30sectomars/psas_testbot/doku/Ausarbeitung.pdf

PROJEKTSEMINAR AUTOMATISIERUNGSTECHNIK, VOL. 12, WS 18/19

# Autonome Kurvenfahrt eines schlangenähnlichen Roboters in dem Strahlrohr eines Ringbeschleunigers

Jens Balze, Nursura Demircan, Elias Jargon, Seyed Davood Mousavi

Zusammenfassung— Bereits heute werden mehrgliedrige, schlangenähnliche Roboter auf Bohrinseln und bei Ölpipelines für Inspektions-, Instandhaltungs- und Reparaturarbeiten eingesetzt. Diese Arbeit setzt sich mit der Regelung der Bewegung eines solchen Roboters, der zukünftig zur Inspektion innerhalb eines Teilchenbeschleunigers eingesetzt werden soll, auseinander. Dabei soll die Fahrt des Roboters so geregelt werden, dass der Roboter sich durch ein Rohr mit ellipsenförmiger Querschnittsfläche bewegen kann. Dieses Rohr besteht aus geraden und gebogenen Abschnitten. Zu diesem Zweck wird in dieser Arbeit ein Modell, das die Bewegung des Roboters im Rohr beschreibt, entworfen. Auf Grundlage dieses Modells werden verschiedene Regelkonzepte ausgelegt und verglichen. Mit diesen entworfenen Reglern ist es dem Roboter möglich, durch ein Modell eines Rohres des Ringbeschleunigers, der zurzeit bei der Gesellschaft für Schwerionenforschung in Darmstadt entsteht, zu fahren. Zudem kann der Roboter mit diesen Reglern ein Rohr einer realen Teststrecke durchfahren, bei dem die Bedingungen durch engere Kurven verschärft wurden. Des Weiteren wird sich mit der Wahl und der Messung einer geeigneten Regelgröße auseinandergesetzt.

Abstract— Already today, multi-limbed, snake-like robots are used on drilling rigs and oil pipelines for inspection, maintenance and repair. This paper deals with the regulation of the movement of such a robot, which should be used for the inspection within a particle accelerator in the future. The aim is to control the motion of the robot so that the robot can move through a pipe. This pipe consists straight and curved sections. For this purpose, a model describing the motion of the robot is derivated in this work. Based on this model, different control concepts are designed. In addition, the robot can use these controllers to drive through a pipe that has tightened the conditions with tighter bends. Furthermore, the choice of the present control variable is discussed.

I. EINFÜHRUNG

Ein wichtiges Einsatzgebiet von mobilen Robotern sind Gebiete, die für den Menschen nicht bzw. schwer zugänglich sind. So werden mobile Roboter beispielsweise in lebensfeindlichen Gebieten zur Erkundung der Ozeane [1] oder des Mars eingesetzt, in gefährlichen Krisengebieten bei Such- und Rettungsaktionen [2] und in einer Vielzahl weiterer Einsatzgebiete. Des Weiteren werden die mobilen Roboter in für den Menschen räumlich unzugänglichen Umgebungen eingesetzt. So wie ein

Diese Arbeit wurde von Nicolai Schweizer, M.Sc. unterstützt.

Roboter, der derzeit am Fachgebiet Regelungsmethoden und Robotik der TU Darmstadt entwickelt wird.
Dieser Roboter soll sich durch das Strahlrohr eines Ringbeschleunigers bewegen, um dort bei möglichen Wartungsarbeiten liegengebliebene Werkzeuge oder andere Fremdkörper zu entdecken und zu lokalisieren. Denn diese Fremdkörper können die Funktion und die Strahlqualität des Ringbeschleunigers stark beeinträchtigen. Da das Strahlrohr, dessen Querschnitt aus einer Ellipse mit den Halbachsen von 30 mm und 60 mm besteht (vgl. II-B), für den Menschen nicht zugänglich ist, müsste er bei der Suche nach einem Fremdkörper an vielen Stellen geöffnet werden, bis der Fremdkörper entdeckt wird. Durch einen Roboter, der sich durch das Strahlrohr bewegt, muss der Ringbeschleuniger nur an einer Stelle geöffnet werden, um den Roboter einzusetzen. Nach der Entdeckung und Lokalisierung des Fremdkörpers muss das Strahlrohr dann nur noch an einer entsprechenden zweiten Stelle geöffnet werden, um den Fremdkörper zu entfernen. Zudem kann der Roboter zur visuellen Inspektion verwendet werden. Der Roboter soll für den bei der Gesellschaft für Schwerionenforschung (GSI) entstehenden Ringbeschleuniger entwickelt werden, aber auch in anderen Ringbeschleunigern einsetzbar sein [3].
Da sich der Roboter nur sehr langsam bewegt und der Ringbeschleuniger der GSI eine Länge von ca. 1100 m hat, ist es wünschenswert, dass der Roboter sich autonom Fortbewegen kann. Zu diesem Zweck soll in dieser Arbeit eine Regelung entworfen werden, die dem Roboter sowohl durch gerade auch gebogene Rohrabschnitte des Teilchenbeschleunigers eine autonome Fahrt ermöglicht. Diese Regelung soll zum einen verhindern, dass der Roboter kippt. Zum anderen soll er einen möglichen Grip-Verlust des Roboters im Rohr vermeiden, denn damit ist ein möglicher Abrieb der Räder verbunden, der die Funktion des Beschleunigers beeinträchtigen kann. Zu diesem Zweck muss der Roboter von der Regelung so durch das Rohr gelenkt werden, dass ein Auffahren an den Rohrwänden verhindert wird, da dies zum Kippen bzw. zum Grip-Verlust führen kann. Die Regelung soll also dafür sorgen, dass sich der Roboter möglichst immer am untersten Punkt des Querschnittes im Rohr befindet.
Der schlangenähnliche Roboter (Abb. 7) besteht aus vier Modulen, die jeweils ein Paar Räder besitzen. Die Module sind über Gelenke miteinander verbunden. Derzeit ist der Roboter in der Lage manuell gesteuert zu werden. Dabei wird eine Geschwindigkeit und ein Lenkwinkel vorgegeben. Aus diesen Werten berechnet ein Algorithmus die nötigen Sollwinkel für die Gelenke und die Geschwindigkeiten für

die einzelnen Räder. Eine ausführlichere Beschreibung des Aufbaus des Roboters zum Zeitpunkt des Beginns der Arbeit und eine Beschreibung der kinematischen Berechnungen zur manuellen Steuerung finden sich in [4].
Zur Umsetzung der Regelung wird der Roboter durch ein passives Gelenk zwischen dem ersten und dem zweiten Modul erweitert, welches eine unabhängige Rollbewegung des ersten Moduls gegen-über dem restlichen Roboter zulässt. Zudem wird eine inertiale Messeinheit (IMU) an der Spitze des ersten Moduls angebracht. Diese hardwaretechnischen Veränderungen werden genauer in Kapitel IV beschrieben.
Nach der Erläuterung einiger Grundlagen zur Bewegung von Rädern in Rohren und einer kurzen Vorstellung der Simulation und der Teststrecke im Kapitel II, wird näher auf die Modellbildung des Systems Roboter im Rohr eingegangen (Kapitel III). Dieses Modell soll als Grundlage zur Wahl verschiedener Regelkonzepte und deren Auslegung dienen. Weiterhin wird in Kapitel IV die Problematik bei der Messung der Regelgröße bzw. der Zustandsgrößen beschrieben. Kapitel V stellt dann die verschiedenen Regelkonzepte und Auslegungen vor, bevor diese in Kapitel VI verglichen und bewertet werden.

II. GRUNDLAGEN

In diesem Kapitel werden einige kinematische Grundlagen zur Bewegung von Rädern und Robotern im Rohr erläutert, die in der Modellbildung vorausgesetzt werden. Zudem wird auf den Komplementärfilter eingegangen, der die vom IMU-Sensor aufgenommenen Werte aufbereitet. Letztlich werden noch die Teststrecke und die Simulation vorgestellt.

A. Bewegung von Rädern und Achsen im Rohr
Um die Bewegung eines Rades in einem Rohr mit kreisförmigem Querschnitt zu beschreiben, müssen zunächst einige Winkel und Koordinaten eingeführt werden. Das Inertialsystem liegt am Beginn des Rohres im Mittelpunkt M der kreisförmigen Grundfläche. Die z-Achse zeigt entlang des Rohres Abb. 1.

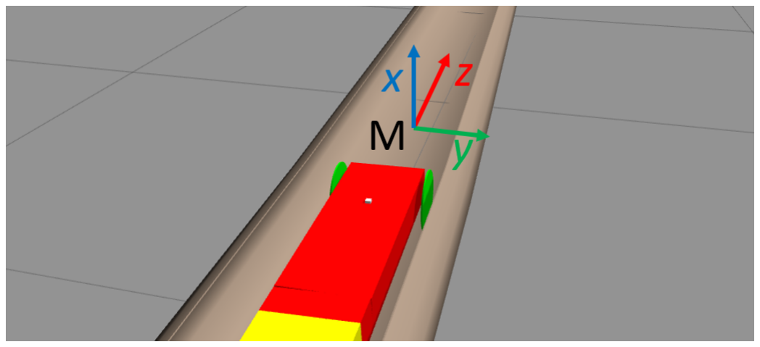
[picture p21: figure]

Abb. 1. Inertialsystem

Zudem wird ein Koordinatensystem eingeführt, dass seinen Ursprung im Aufstandspunkt des Rades auf der Innenfläche des Zylinders, welcher das Rohr beschreibt, hat. Dieser Punkt wird mit Q bezeichnet. Das Koordinatensystem wird nun durch (τ ,b,n) aufgespannt. Dabei zeigt die τ -Achse in die Bewegungsrichtung des Roboters. Sie stellt also eine Tangente zur Rohroberfläche im Punkt Q dar. Die b-Achse ist ebenfalls eine Tangente im Punkt Q auf die Oberfläche des Rohres. Die b-Achse steht senkrecht auf der Bewegungsrichtung. Damit ergibt sich für die n-Achse, dass sie senkrecht auf der Rohroberfläche steht und somit in Richtung der Rohrachse zeigt. r bezeichnet den Radius des Rades. Der Winkel zwischen dem Rad und der n-Achse wird als β bezeichnet. Des Weiteren wird noch der Winkel ψ benötigt. ψ wird zur Beschreibung des Gierwinkels des Roboters verwendet. Er wird von einer parallelen zur z-Achse und der Bewegungsrichtung aufgespannt. Da dieser Winkel später für Rad und Roboter gleich ist wird auch für das Rad ψ verwendet. In Abb. 2 wird er durch die gestrichelten Linien m und l aufgespannt. Wobei l eine Parallele zur z-Achse ist und m die Verlängerung von der τ -Achse ist. Neben dem Gierwinkel ψ, werden auch für

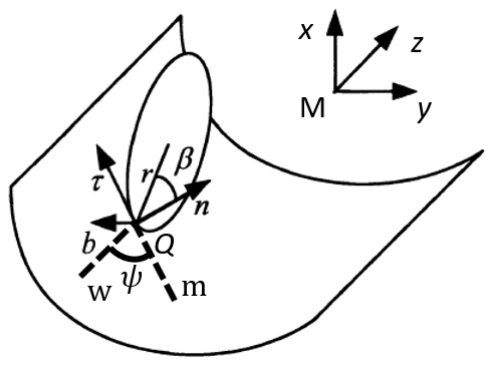
[picture p22: figure]

Abb. 2. Rad im Rohr nach [6]

Rollwinkel ϕ und den Nickwinkel θ, des Roboters die in Fahrzeugtechnik üblichen Winkelbezeichnungen verwendet. Für den Punkt Q ergibt sich nun mit der Winkelgeschwindigkeit ω des Rades in Abhängigkeit der Zeit t nach [6]:

Qx(t) = rRohr sin(−ωtr sin(ψ)

rRohr

) | (1)

Qy(t) = rRohr sin(−ωtr sin(ψ)

rRohr

) | (2)
Qz(t) = −ωtr cos(ψ) | (3)

Damit bewegt sich der Radaufstandspunkt auf einer Schraubenlinie, solange der Winkel ψ nicht verändert wird. Des Weiteren fällt auf, dass die Trajektorie des Punktes Q unabhängig vom Winkel β ist. β hat erst dann einen Einfluss, wenn es um die Berechnung des Radmittelpunktes geht. Somit wirkt es sich auch bei der Berechnung der exakten Position eines Punktes, der auf dem Roboter liegt, aus. Für die Modellbildung muss die Bewegung des Rades nun auf die Bewegung einer Achse im Rohr erweitert werden. Betrachtet man nun eine Achse mit zwei Rädern im Rohr, so ändert sich der Winkel β der beiden Räder mit dem Winkel ψ. Aus Symmetriegründen ist der Winkel β1 des ersten Rades gleich minus β2 des zweiten Rades. Damit ist die Radachse eine Parallele zu einer Tangente, die den Kreis mittig unter dem Roboter berührt (Abb. 3). Durch die Steifigkeit stellt sich also im kompletten ersten

AUTONOME KURVENFAHRT EINES SCHLANGENÄHNLICHEN ROBOTERS IN DEM STRAHLROHR EINES RINGBESCHLEUNIGERS

Modul die Neigung der Tangente ein. Dies ist unabhängig vom Winkel ψ. Deshalb wird die Position des Roboters Roboter durch den Berührungspunkt der Tangente beschrieben. Damit ist auch die Bewegungsrichtung von diesem Punkt nur von der Bewegungsrichtung der Aufstandspunkte der Räder abhängig und kann durch die Formeln 1, 2 und 3 beschrieben werden. Hier sind alle Variablen für beide Räder gleich, da diese parallel zueinander sind. Lediglich die Winkelgeschwindigkeiten ω können bei einer Kurvenfahrt leicht variieren. Dieser Unterschied ist allerdings so gering, dass er vernachlässigt werden kann. Zur Berechnung des Punktes PRoboter wird ωr durch die vorgegebene Robotergeschwindigkeit vRoboter ersetzt.


Abb. 3. Achse mit zwei Rädern im Rohr

B. Simulation
Zu Beginn der Projektarbeit wurde eine Simulationsumgebung bereitgestellt, die sowohl ein Modell des Roboters enthält als auch ein Modell des Strahlrohres, dass wie auch in der Realität einen ellipsenförmigen Querschnitt mit den Halbachsenlängen von 30 mm und 60 mm besitzt. Das Rohr besteht aus einem geraden Abschnitt zu Beginn und einer Kurve mit dem Radius von 52632 mm. Dieser Kurvenradius entspricht dem Radius, der auch in den Kurven des bei der GSI entstehenden Ringbeschleunigers auftritt. Des Weiteren wird hier auch eine IMU simuliert, deren Messergebnisse mit einem Rauschen beaufschlagt werden. In dieser Simulation können Regler-Implementierungen getestet werden, bevor sie auf der realen Teststrecke genutzt werden, damit mögliche Schäden am Roboter durch Fehlfunktionen vermieden werden. Zudem kann die Performance der Regler mit den entsprechenden Kurvenradien der Realität beurteilt werden. Das Problem der Simulation besteht darin, dass der Roboter nur bis zu einem bestimmten Auslenkung den untersten Punkt des Rohres verlässt und dann selbständig auch ohne Regelung dem Verlauf des Rohres folgt. Deshalb muss bei der Simulation darauf geachtet werden, dass der Roboter nicht in diesen Bereich gelangt, da den Simulationsergebnissen dann nicht mehr zu trauen ist. Dieses Problem konnte im Rahmen dieser Arbeit nicht gelöst werden. Allerdings sind die erarbeiteten Regelmethoden ausreichend gut, sodass diese kritische Auslenkung nicht erreicht wird.
C. Reale Teststrecke
Zum Testen der Regelung steht nicht das Originalrohr aus dem Teilchenbeschleuniger zur Verfügung. Hierbei ist auch zu beachten, dass der Roboter universell in verschiedenen Rohren eingesetzt werden soll und dass sich die Abmessungen des Rohrquerschnitts im Teilchenbeschleuniger auch ändert. Daher ist es nicht sehr wichtig das Rohr exakt nachzubilden. Als Rohrersatz dient deshalb ein flexibles Lüftungsrohr, welches längs der Rohrachse halbiert wurde, um beobachten zu können, wie sich der Roboter verhält. Zusätzlich ermöglicht das Aufschneiden ein Aufbiegen des Rohres und somit eine Veränderung des Rohrradius. Dieses Setup war bereits zu Beginn der Arbeit vorhanden. Aus diesem Rohr wird eine Teststrecke aufgebaut, die aus einem geraden Abschnitt am Anfang des Rohres besteht, um zu testen, wie sich der Roboter beim Einschalten verhält, besonders dann, wenn er nicht parallel zur Rohrachse eingesetzt wird. Danach befindet sich eine Rechtskurve, gefolgt von einer Linkskurve, um die Kurvenfahrt zu untersuchen. Dabei wird der Kurvenradius wesentlich enger gewählt als im Original, um den Roboter unter verschärften Bedingungen testen zu können. Ein engerer Kurvenradius führt, wie später in Kapitel 3 beschrieben wird, laut Formel (10) zu größeren Störungen des Systems und stellt daher eine größere Schwierigkeit bei der Regelung dar. Da das Rohr einen sehr geringen Reibwert besitzt und Unebenheiten die Messungen der IMU stark beeinträchtigen, wird in das Rohrinnere eine Anti-Rutschfolie geklebt.

III. MODELLBILDUNG
Als Grundlage zur Reglerauslegung dient ein mathematisches Modell, das die Bewegung des Roboters im Rohr beschreibt. Dieses Modell wird unter der Annahme einiger Vereinfachungen aus der Kinematik des Systems mit anschließender Linearisierung hergeleitet. Im Folgenden wird die Herleitung beschrieben. Zunächst wird das Rohr als ein kreisförmiger Zylinder angenommen. Im Teilchenbeschleuniger ist der Rohrquerschnitt ellipsenförmig. Da sich der Roboter aber ausschließlich im unteren Bereich des Rohres aufhält, wird für das Modell eine kreisförmige Querschnittsfläche verwendet. Zudem werden Kurven entlang der z-Achse vernachlässigt und in der Regelung als Störung angenommen.
Um die Position des Roboters PRoboter im Rohr zu beschreiben, gibt es verschiedene Möglichkeiten. Da sich der Roboter immer auf der Rohrinnenfläche befindet, genügen zwei Variablen als Minimalkoordinaten für die exakte Beschreibung der Position. Diese Minimalkoordinaten bestehen zum einen aus der Verschiebung des Roboters in z-Richtung und zum anderen aus einer Variablen, die die Auslenkung aus dem untersten Punkt im Rohr beschreibt. Da das Rohr als gerade angenommen wird, ändert sich das System in Abhängigkeit der z-Position nicht. Lediglich die Störung, die auf das System wirkt, hängt von der z-Position ab. Da aber unbekannt ist, an welchen Stellen vom Rohr sich eine Kurve befindet und somit

eine Störung vorhanden ist, wird dieser Wert nicht benötigt. Abb. 4 zeigt drei mögliche Variablen zur Beschreibung der Auslenkung. Die möglichen Variablen sind die Auslenkung in y-Richtung yRoboter die Kreisbogenlänge b zwischen dem untersten Punkt im Rohr bis zum Roboter und der Winkel α. Dieser Winkel α wird von der x-Achse und einer Verbindungslinie vom Mittelpunkt des Rohrquerschnittes zum Punkt PRoboter aufgespannt. Die Auslenkung in y-Richtung wird nach

yRoboter = rRoboter sin(α) | (4)

berechnet. Um die dadurch entstehenden Nichtlinearitäten zu vermeiden, wird sich gegen diese Variable entschieden. Der Winkel α entspricht näherungsweise dem Rollwinkel ϕ, der von der IMU gemessen werden kann (vgl. Kapitel Messung). Deshalb wird sich im mathematischen Modell für diesen Winkel als Regelgröße entschieden. Ziel der Regelung ist es, α zu null zu bringen, damit sich der Roboter an unterster Stelle im Rohr befindet. Der Zustand des Roboters wird zusätzlich durch den Gierwinkel ψ beschrieben.


Abb. 4. Mögliche Minimalkoordinaten

Als Stellgröße für das System kann der Lenkwinkel δ1 des Roboters vorgegeben werden (vgl. Einleitung). Aus diesem ergibt sich laut [4] aus dem Abstand der ersten Radachse zur Spitze des Roboters Lp1J1

und der Geschwindigkeit vRoboter für die Gierrate

ψ˙ =

tan(δ1)

Lp1J1

vRoboter . | (5)

Durch Integration ergibt sich die Zustandsvariable ψ. Die Geschwindigkeit des Roboters vRoboter liegt konstant bei 0,05 m/s. Diese Geschwindigkeit soll nun in die Umfangskomponente vu und die Axialkomponente vz bezogen auf den Rohrradius aufgeteilt werden (Abb. 5). Durch Integration der Formeln 1, 2 und 3 ergeben sich die Geschwindigkeitskomponenten des Punktes PRoboter. Aus der x- und der y-Komponente kann die Umfangsgeschwindigkeit

vu =

q
v

2
x + v

2
y

(6)

berechnet werden. Damit ergeben sich für die Geschwindigkeitskomponenten vu und vz:

vu = vRoboter.sin(ψ) | (7)
vz = vRoboter. cos(ψ) | (8)

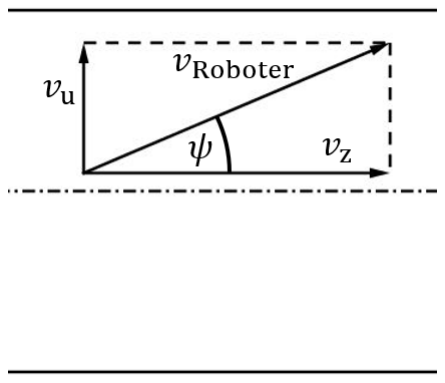
[picture p23: figure]

Abb. 5. Aufteilung der Geschwindigkeit

Aus der Umfangskomponente vu und dem Rohrradius rRohr ergibt sich die Änderungsrate des Winkels α nach der Formel:

α˙ =

vu

rRohr

(9)

Und somit durch Integration die Zweite Zustandsvariable α, die der Regelgröße entspricht. Zuletzt wird noch die Störung berechnet, die in einer Kurve auf das System wirkt. Dazu wird die Geschwindigkeitskomponente in Axialrichtung vz verwendet. Wird angenommen, dass der Roboter geradeaus fährt, so biegt sich die Rohrachse mit

ψ˙
str =

vz

rKurve

(10)

weg von der Bewegungsrichtung des Roboters und wirkt so als Störung auf den Eingang des Systems. Da der Gierwinkel im Bereich von −3

- bis +3◦
liegt, kann der Kosinus in Formel 8 zu eins angenommen werden und somit entspricht vz = vRoboter. Der Kurvenradius im Teilchenbeschleuniger rKurve beträgt 52632 mm, sodass sich in der Kurve eine sehr geringe Störung von ca. 9.5∗10⁻⁴
rad/s einstellt. Letztendlich wird auch die Formel (7) durch die Kleinwinkelnäherung linearisiert. Die Nichtlinearität, die durch den Eingang δ1 entsteht, kann durch eine Eingangslinearisierung vermieden werden. Dadurch berechnet der Regler die Gierrate ψ˙
, die im
Gegensatz zu δ1 linear auf das System wirkt. Da dem Roboter allerdings kein ψ˙ vorgegeben werden kann, sondern nur der Lenkwinkel δ1, muss dieser aus der Gierrate berechnet werden. Die Formel für δ1 ergibt sich durch umstellen von 5 zu

δ1 = arctan(ψ˙

Lp1J1

vRoboter

) . | (11)

Somit ergibt sich das Gesamtmodell in Abb. 6. Die Übertragungsfunktion lautet:

GStrecke(s) = vRoboter

rRohr

1 s
2 | (12)

Und im Zustandsraum:

| (13)

x˙ = A x + bu

| (14)
α˙
ψ˙
=
0

vRoboter
rRohr
0 | 0 | α ψ
+
0
1
ψ˙

(15)

y = c

T x =

1 0

α
ψ
= α

Die Halbachsen der Ellipse im Teilchenbeschleuniger betragen 30 mm und 60 mm. Deshalb wird der Rohrradius zu 100 mm angenommen, um den unteren Bereich des elliptischen Rohres anzunähern. Die digitalisierte Strecke unter Berücksichtigung des AbtastHalte-Gliedes mittels z-Transformation ergibt:
GStrecke(z) = 1
T²

rRohr

vRoboter

z − 1
z + 0.5

(16)


Abb. 6. Blockschaltbild der Strecke

IV. MESSUNG
Zur Messung der Regelgröße wird eine inertiale Messeinheit (IMU) verwendet. Diese misst die linearen Beschleunigungen in allen Raumrichtungen und die Winkelbeschleunigungen um alle Koordinatenachsen.
Zum Einsatz in diesem Projekt kommt eine Messeinheit von iNEMO. Sie wird unter der Typenbezeichnung LSM6DS33 gelistet. Dieser Chip arbeitet im Performance-Mode mit bis zu 1,66 kHz und einem Wertebereich von +/- 2G, beziehungsweise +/- 250 DPS. Da der Roboter mit einer niedrigen Geschwindigkeit durch einen Ringbeschleuniger fahren wird, kann davon ausgegangen werden, dass er nicht mit großen linearen Beschleunigungen und großen Winkelbeschleunigungen konfrontiert wird. Somit ist der gewählte Wertebereich ausreichend und entspricht der Standardeinstellung der Messeinheit. Da die Datenmenge, die über die Funkverbindung übertragen werden kann, begrenzt ist, wird der Sensor mit einer Frequenz von 100 Hz ausgelesen. [7]
Zur Verbesserung der Genauigkeit des Beschleunigungssensors wird eine Biaskorrektur auf dem Mikrocontroller durchgeführt. Die Messeinheit kommuniziert mittels I2C mit dem Board. [8]
Das Koordinatensystem der IMU weicht von dem Koordinatensystem, welches für die Modellbildung verwendet wird, ab (siehe Abb. 7). Durch Integration der Winkelbeschleunigungen können die Drehraten und die Lage bestimmt werden. Ein Komplementärfilter nutzt neben der Integration auch die Anteile der Erdbeschleunigung an den einzelnen Koordinatenachsen und vergleicht die Werte mit der Integration der Winkelbeschleunigungen. So wird das Messrauschen verringert und eine Drift der Lage, welcher durch aufsummieren von Messfehlern entsteht, verhindert [9]. Lediglich die Drift um die raumfeste Achse, die parallel zur Erdbeschleunigung verläuft, kann nicht verhindert werden. Diese driftbehaftete Drehung entspricht in dieser Arbeit der Drehung um den Winkel ψ.

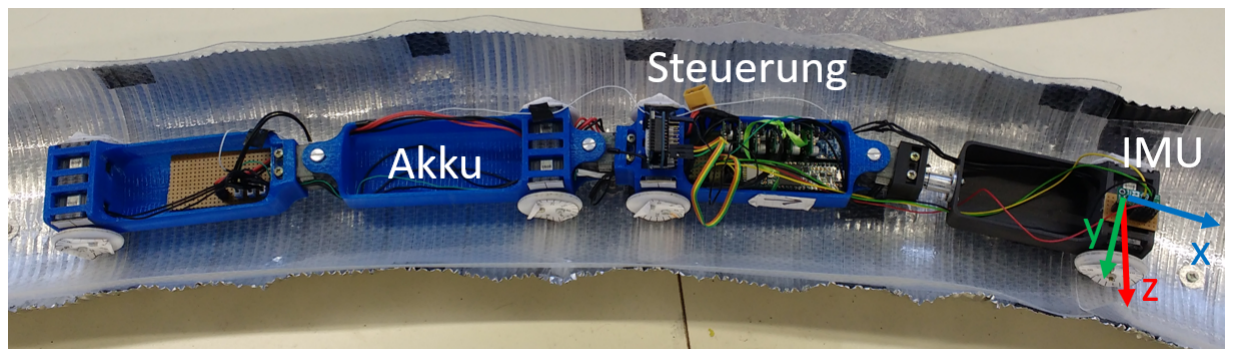
[picture p24: figure]

Abb. 7. Roboter mit IMU-Koordinaten

Nimmt man an, dass das Gelenk zwischen dem ersten und dem zweiten Modul des Roboters nicht eingeknickt ist, so besteht zwischen den Zustandsgrößen α und ψ und den Messwerten ϕ und θ der Zusammenhang:

sin(ϕ) = cos(ψ) sin(α) | (17)

ϕ = arc(

az
−g
) | (18)

Diese können nach ψ und α umgestellt werden. Durch den großen Radstand zwischen der ersten Achse und der zweiten Achse des Roboters, bleibt der Nickwinkel beim Auffahren im Rohr so gering, dass er nicht Messbar ist und nahezu keinen Einfluss auf α hat, sodass α = ϕ gesetzt werden kann. Bzw. cos(ψ) = 1, da auch ψ sehr klein ist (vgl. Kapitel III). Da die Werte für die Lage durch den Komplementärfilter an Auflösung verlieren, wird der Rollwinkel ϕ direkt aus den Anteilen der Erdbeschleunigung auf den einzelnen Achsen berechnet. Hier kann sowohl der Anteil in z-Richtung verwendet werden

ϕ = arccos( az
−g
) | (19)

als auch der Anteil in y-Richtung

ϕ = arcsin( ay
−g
) . | (20)

Es wird sich für eine Berechnung nach (20) entschieden, da ay im Bereich von ϕ = 0 stärker variiert, denn der Sinus ist in diesem Bereich wesentlich steiler als der Kosinus. Damit wird ein größeres Verhältnis zwischen Messwert und Rauschen geschaffen. Aus dem Nickwinkel und dem Rollwinkel könnte auch die Zustandsgröße ψ (Gierwinkel) berechnet werden, solange die IMU nicht parallel zur yz-Ebene ausgerichtet ist. In der yz-Ebene kommt es zu einer Singularität, die die Berechnung verhindert. Allerdings kann diese Berechnung durch den zu kleinen Nickwinkel ebenfalls nicht angewendet werden. Auch die Bestimmung des Gierwinkels durch Integration ist möglich, da als Bezugspunkt die Rohrachsenrichtung dient (vgl. Kapitel III). Dieser Bezugspunkt ändert sich jedoch mit dem unbekannten Verlauf des Rohres. Bei der Integration der Winkelbeschleunigung hingegen bleibt der Bezugspunkt immer gleich, bzw. ist Drift behaftet. Die Position des Sensors ist oberhalb der ersten Radachse. Der Sensor wurde oberhalb der ersten Radachse positioniert. Da der Roboter sehr steif ist für Torsion um seine Achse in Bewegungsrichtung (rot eingezeichnete Achse in Abb. 8), bleibt der Rollwinkel des vorderen Moduls näherungsweise gleich zu den anderen Modulen. Dies hat zur Folge, dass das erste Modul sich nicht verdreht und kein Rollwinkel gemessen werden kann. Fährt der Roboter beispielsweise an der linken Rohrwand auf, so verliert das rechte Rad den Bodenkontakt und der Rollwinkel bleibt näherungsweise gleich zu dem aktuellen Rollwinkel der restlichen Module, die sich noch im unteren Teil des Rohres befinden. Die Regelabweichung ist also nicht messbar. Daher wird ein passives Gelenk in das erste Modul eingefügt, dass eine Rollbewegung unabhängig von den anderen Modulen zulässt (siehe Abb. 8)

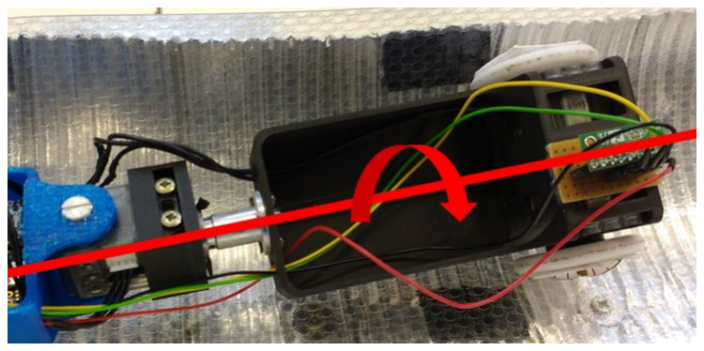
[picture p25: figure]

Abb. 8. Passives Gelenk zur Bestimmung des Rollwinkels

Dadurch, dass der Sensor nicht perfekt ausgerichtet werden kann, wird der Rollwinkel im Stand auf einer horizontalen Fläche gemessen, um den Offset zu bestimmen. Der Offset beträgt 0,134 rad bei einer Standardabweichung von 0,004 rad. Befindet sich der Roboter allerdings in Bewegung, so beträgt die Standardabweichung 0,167 rad. Dies ist auf Vibrationen beim Fahren zurückzuführen.

V. REGLER
Zur Regelung des Roboters werden verschiedene Regelungskonzepte und Auslegungsmethoden verwendet. Zum einen wird eine Ausgangsregelung in Form eines proportionaldifferential Reglers (PD-Regler) umgesetzt, der mittels dem

Wurzelortskurvenverfahren ausgelegt wird. Zum anderen wird ein Zustandsregler verwendet, dessen Parameter nach zwei unterschiedlichen Verfahren bestimmt werden. Bei den Verfahren handelt es sich um Polplatzierung und die linear-quadratische Regelung (LQR). Da die Zustände nicht gemessen werden können, werden zusätzlich noch Beobachter verwendet. Dabei handelt es sich zum einen um einen Luenberger-Beobachter in Kombination mit einem Filter und zum anderen um ein Kalman-Filter. In den folgenden Unterkapiteln werden diese Konzepte erläutert.
Für den PD-Regler ist auch eine Filterung der Messgröße erforderlich. Hierzu wird derselbe Filter wie für den Luenberger-Beobachter verwendet. Es handelt sich um einen Moving-Average aus den letzten 20 gemessenen Werten.
Die Stellgrößenbeschränkung ergibt sich durch die mangelnde Bewegungsfreiheit für den Roboter im Rohr und durch den maximalen Winkel, der an den Gelenken eingestellt werden darf. Wobei erstere wesentlich geringere Stellgrößen zulässt. Zur Festlegung dieses Wertes wird der Roboter per Hand durch die Teststrecke gesteuert und immer wieder dem maximalen Lenkwinkel ausgesetzt. Dieser wird per Durchlauf immer weiter erhöht. Wird der maximale Lenkwinkel zu groß, so kann es passieren, dass einzelne Module gegen die Rohrwand drücken, da die nötige Bewegungsfreiheit nicht gegeben ist. Daher wird der maximale Lenkwinkel auf 4◦ gesetzt. So wird verhindert, dass der eben beschriebene Fall eintritt und dadurch hohe Belastungen auf die Gelenke wirken. Damit sollen durch diese Stellgrößenbeschränkung auch Schäden am Roboter vermieden werden. Für den Regler ergibt sich so nach Formel (5) eine maximale Stellgröße von 0,233 rad/s für ψ˙
. Weiterhin ist zu beachten, dass sämtliche Werte zur Reglerauslegung für kontinuierliche Systeme angegeben sind. Für die Implementierung werden diese Werte digitalisiert.
A. PD-Regler

Für eine Ausgangsregelung muss nur die Regelgröße eines Systems gemessen werden. Da der Gierwinkel ψ, der eine Zustandsvariable des Systems darstellt, nicht gemessen werden kann (vgl. Kapitel III), bietet sich diese Regelmethode für das vorliegende System an. Durch die Linearisierung kann auf eine Großzahl an linearen Auslegemethoden zurückgegriffen werden. Letztendlich wird sich hier für das Wurzelortskurvenverfahren entschieden, da so die Dynamik des Systems besonders gut eingestellt werden kann [10]. Die Strecke weist einen doppelten Pol in null auf und ist somit instabil. Deshalb wird ein differentieller Anteil (D-Anteil) im Regler benötigt, der das System stabilisiert. Die Störgröße, die durch die Kurvenfahrt entsteht, greift noch vor dem ersten Integrator der Strecke an (Abb. 6). Daher ist ein integraler Anteil (I-Anteil) im Regler nötig um diese Störung stationär genau auszuregeln. Allerdings ist die Störung sehr klein gegenüber anderer Systemgrößen (vgl. Kapitel III), sodass der I-Anteil nicht benötigt wird.
Bei der Auslegung mittels Wurzelortskurve (WOK) ist zu beachten, dass der Regler so eingestellt wird, dass die Stellgrößenbeschränkung eingehalten wird. Zudem darf der D-Anteil nicht zu groß gewählt werden, da dieser das Messrauschen verstärkt. Dadurch schwankt die Stellgröße zwischen ihrem maximalen und minimalen Wert und es ist keine Reaktion auf die Regelabweichung möglich. Je größer der Filter gewählt wird, desto größer kann auch der D-Anteil gewählt werden. Allerdings führt der Filter auch zu einer Zeitverzögerung, die mit der Filtergröße ansteigt. Daher darf auch der Filter nicht zu groß gewählt werden. Bei einer Filtergröße von 20 Werten, über die der Mittelwert berechnet wird, ist die Zeitverzögerung so gering, dass sie gegenüber der Zeitkonstanten des Systems vernachlässigt werden kann. Der Verstärkungsfaktor für den D-Anteil kann in diesem Fall bis ca. 4 erhöht werden, ohne dass diese Stellgröße große Sprünge aufweist.
Letztendlich ergibt sich der Regler zu
Gr(z) = 279,4z − 276,6z
z − 0,3116
. | (21)
B. Zustandsregler mittels Polplatzierung
Bei der Auslegung eines Zustandsregler mittels Polplatzierung sind die Pole des geschlossenen Regelkreises frei wählbar, was dazu führt, dass die Dynamik des Regelkreises frei bestimmbar ist. Dazu werden allerdings auch mehr Informationen über den aktuellen Systemzustand benötigt. So werden wie in Abb. 9 zu sehen alle Zustandsgrößen zurückgeführt und mit dem Regelvektor k

T
verstärkt. Die Stellgröße ergibt sich noch zusätzlich nach [10] aus der Vorverstärkung ν zu:

u = νω − k

T
x | (22)

Da die Sollgröße ω allerdings null ist, entfällt der erste Teil der Gleichung und u berechnet sich nur aus - k

T
x

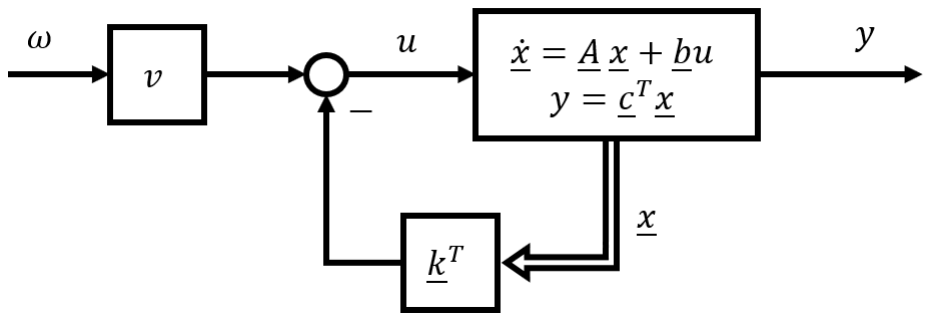
[picture p26: figure]

Abb. 9. Blockschaltbild eines Zustandsregler nach [10]

Um einen Zustandsregler zu benutzen muss noch die Steuerbarkeit nachgewiesen werden. Dafür muss die Steuerbarkeitsmatrix Ms nach [10] vollen Rang haben, beziehungsweise eine Determinante ungleich null:

det(Ms) =

b A b
=

0

vRoboter
rRohr
1 0

= −

vRoboter

rRohr

6= 0

(23)
Jetzt können die Eigenwerte des Systems unter der Berücksichtigung der Stellgrößenbeschränkung frei gewählt werden und daraus der Regelvektor k

T
berechnet werden. Die
Wunschpole werden beide auf -1 gelegt. Damit ergibt sich k

T
zu -

0,5 2
. (Vgl. [10])
Letztlich müsste für den Zustandsregler noch ein I-Anteil vorgeschaltet werden, um die Störung stationär genau auszuregeln. Hier gilt allerdings dasselbe wie bei dem PD-Regler in Abschnitt V-A. Die Störung ist so gering, dass der I-Anteil nicht benötigt wird.
C. Zustandsregler mittels LQR

Die LQR ist eine weitere Auslegungsmethode für Zustandsregler. Dafür wird ein Gütemaß für die Regelung berechnet, welches anschließend durch Bestimmung des Regelvektors k

T
optimiert wird. Bei dem Gütemaß werden die Zustände quadriert und mit der Matrix Q gewichtet. Zudem wird auch die Stellgröße quadriert und mit R gewichtet. So hat man im Gütemaß eine Größe, mit der die später im Regler verwendete Stellgröße direkt bewertet werden kann und so auch bei der Auslegung direkt beeinflusst werden kann. Der weiteren werden durch das Quadrieren große Abweichungen von der Ruhelage besonders schlecht bewertet, was auch eine gute Beeinflussung des Zeitverhaltens mit sich bringt. Das quadratische Gütemaß berechnet sich nach [10] mit der Formel:
J =

Z ∞

0

x

T Q x + Ru²
(24)

Hierbei ist darauf zu achten, dass die Ruhelage in den Ursprung transformiert wird, sodass das Integral konvergiert. Mit Werten für Q gleich Einheitsmatrix I und 200 für R ergibt sich der Regelvektor k

T
zu -

0,2752 0,0707
D. Vollständiger Luenberger-Beobachter

Um die Zustandsregler zu benutzen, ist es nötig, dass der komplette Zustandsvektor zur Verfügung steht. da wie bereits in Kapitel IV erwähnt, die Zustandsgröße ψ nicht gemessen werden kann, muss der Zustandsvektor mittels eines Beobachters bestimmt werden. Der Beobachter besteht aus dem in Kapitel III beschriebenen Modell der realen Regelstrecke. Dieses Modell wird mit denselben Stellgrößen wie die reale Strecke beaufschlagt und berechnet so den Zustandsvektor. Um Fehler durch Modellungenauigkeiten, Störungen und Anfangsbedingungen zu vermdeiden, werden die Ausgangsgrößen der realen Strecke und des Modells miteinander verglichen und der Fehler über den Gewichtungsvektor l zurückgeführt. Abb. 10 veranschaulicht den Beobachter, wobei die mit Tilde gekennzeichneten Werte vom Beobachter geschätzt werden.

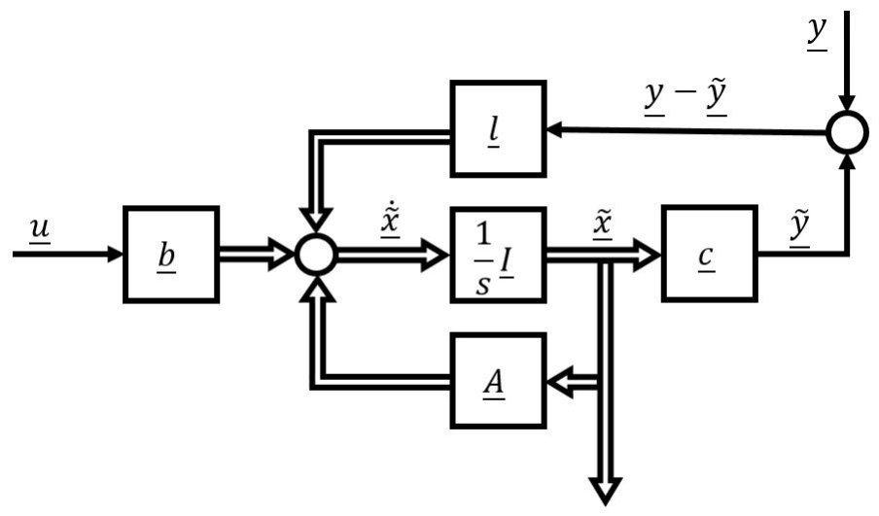
[picture p27: figure]

Abb. 10. Luenberger-Beobachter [10]

Über den Vektor l können die Eigenwerte des Beobachters festgelegt werden. Diese sollen laut Faustformel [10] das 5-10 fache weiter links in der komplexen Ebene liegen als die dominanten Eigenwerte des geschlossenen Regelkreise, damit

mögliche Fehler vom Beobachter schnell gegen null konvergieren. Allerdings dürfen die Pole auch nicht zu weit links liegen, da der Beobachter sonst differenzierendes verhalten aufweist. Dies ist besonders bei verrauschten Messsignalen problematisch, da so das Rauschen verstärkt wird. Bei dem in Abschnitt V-A beschriebenen Filter können die Beobachterpole nicht weiter links liegen als bei -5 in der komplexen Ebene. Damit sind sie 5 mal schneller als der Regelkreis, der mittels Polplatzierung ausgelegt wird. Der Vektor l wird über das Verfahren der Polplatzierung berechnet und ergibt sich zu

10 50
E. Reduzierter Beobachter

Der reduzierte Beobachter berechnet nicht den kompletten Zustandsvektor. Er berechnet nur die Zustandsgrößen, die nicht gemessen werden können. Dazu benutzt er neben der Stellgröße auch die gemessenen Zustandsgrößen, um zum einen den Schätzfehler zu minimieren und zum anderen möglichst viel Information über den Systemzustand zu nutzen. In diesem Fall wird die Zustandsgröße ψ geschätzt, während die Auslenkung α gemessen werden kann.

F. Diskretes Kalman-Filter

Für den Entwurf eines Leuenberger-Beobachters ist es wichtig, dass das System nicht stark rauschbelastet ist. Deshalb wird die Messgröße für diesen Beobachter gefiltert. Dies führt allerdings zu einer Zeitverzögerung. Eine weitere Möglichkeit, um mit dem Rauschen umzugehen, ist die Verwendung eines Kalman-Filters. Dieser kommt ohne einen vorangeschalteten Filter aus. Aus dem verrauschten Ausgang und dem Eingang wird der Zustandsvektor rekonstruiert. Das Kalman-Filter besitzt somit die gleiche Struktur wie der Luenberger-Beobachter (Abb. 10). Auch hier wird der Schätzfehler e = x − x˜ mittels des Beobachtervektors k so beeinflusst, dass er asymptotisch gegen Null strebt. Der Vektor k soll so bestimmt werden, dass die Rauscheinflüsse nx,k und ny,k auf den geschätzten Zustandsvektor x˜ minimiert werden.
Da die Bewegung des Fahrzeugs ebenfalls gestört (im Sinne von überlagertem, normalverteiltem Rauschen) ist, wird dies über die Prozess-Rausch-Kovarianzmatrix Q eingebracht. Diese Matrix teilt dem Filter mit, wie der Systemzustand von einem zum nächsten Schritt springen kann. Die Matrix Q ist Kovarianzsystemrauschen und kann nicht praktisch ermittelt werden. Wie üblich wird Q hier als Einheitsmatrix gewählt. R ist die Messkovarianzmatrix und gibt an, wie sehr man den Messwerten der Sensoren vertrauen kann. Da wir nur α messen, ist dies ein Skalar. Ist der Sensor sehr genau, so sollten hier kleine Werte eingesetzt werden. Ist der Sensor relativ ungenau, so sollten hier große Werte eingesetzt werden.

Es wird das zeitdiskrete System nach [11]

xk+1 = Ak + Bkuk + nx,k
y˜k = Ckxk + Dkuk + ny,k

(25)

betrachtet.

Das Systemrauschen nx,k und das Messrauschen ny,k sind jeweils mittelwertfrei, in sich unkorreliert und besitzen die Kovarianzmatrizen.
Das Systemrauschen beschreibt tatsächliche Änderungen des Zustandsvektors. Idealerweise würde der Schätzwert diesem Rauschen daher folgen. Das Messrauschen beschreibt Störungen, die der Schätzwert idealerweise ignorieren würde.

Qk = E(nx,kn

T
x,k)
E(nx,k) = 0 E(nx,kn

T
x,l) = 0 ∀k 6= l
Rk = E(ny,kn

T
y,k)
E(ny,k) = 0 E(ny,kn

T
y,l) = 0 ∀k 6= l

(26)

Initialschätzwert:

E(ˆx0) = E(x0)
Cov(x0 − xˆ0,x0 − xˆ0) = p0

(27)

Praediktionsschritt: Dieser Teil des Kalman-Filter wagt nun eine Vorhersage des Systemzustands in die Zukunft.

xˆk+1,− = Akxˆk,+ + Bkuk

pk+1,− = Akpk,+AT
k + Qk

(28)

Korrekturschritt: Liegen neue Messdaten vor, so besteht die Aufgabe darin, ausgehend von dem geschätzten Systemzustand xˆk,−, mit der bekannten Kovarianz p∆,k,−, des Schätzfehlers und den Messwerten y˜k mit der py,k einen neuen Schätzwert xˆk,+ zu bestimmen, der biasfrei ist und dabei die minimale Varianz besitzt. ( vgl. Abbildung 11)

kk = pk,−c

T
k

.(ckpk,−c

T
k + Rk)

−1
xˆk,+ = ˆxk,− + kk.(˜yk − (ckxˆk,− + Dkuk)) pk,+ = (I − kkck).pk,−

(29)

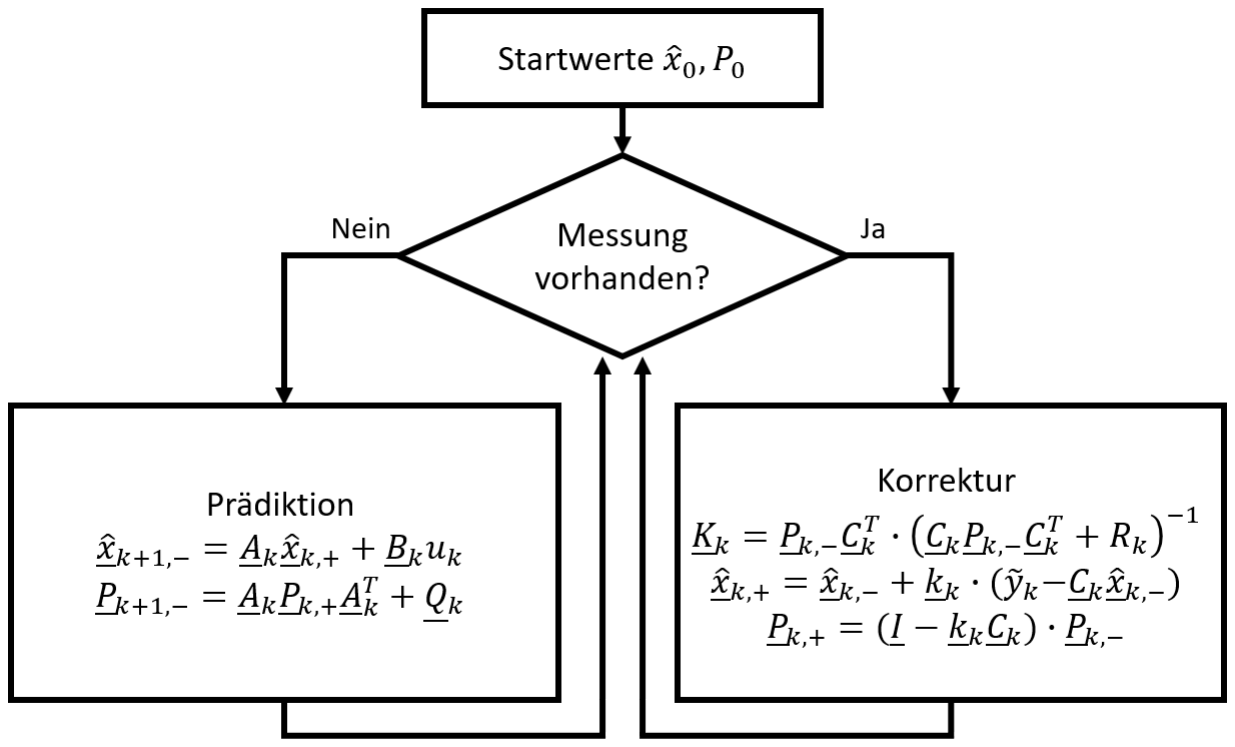
[picture p28: figure]

Abb. 11. Kalman Filter nach [11]

VI. BEWERTUNG
In diesem Kapitel sollen die entworfenen Regler-Konzepte und Auslegungen miteinander verglichen werden. Zu diesem Zweck werden die fünf folgenden Regler untersucht:
1) PD-Regler: kP=4 | kD=0,5 | Fg=10

2) Zustansregler mittels Polplatzierung
2.1) Zustandregler mittels Polplatzierung + Luenberger-Beobachter: Fg=10
l=
0,037

0,0684

k=
1,8

1,8955

2.2)Zustandregler mittels Polplatzierung + Kalman-Filter: k=
0,8

1,398

Q=
10 0

0 5
R=0,0016
2.3) Zustandregler mittels LQR + Luenberger-Beobachter: Fg=10-20???
l=
10

50

k=
0,4279

0,1581

3) Zustandsregler mittels LQR + Kalman-Filter: k=
0,4279

0,1581

Q=
10 0

0 1
R=0,0016

Bei dem Ansatz mit dem reduzierten Beobachter sind die Simulationsergebnisse so schlecht, dass die kritische Auslenkung von +/-4◦
für α erreicht wird. Bei dieser Auslenkung kommt es zu der in Abschnitt II-B beschriebenen selbständigen Kurvenfahrt des Roboters. Auf der realen Teststrecke kommt es zum kippen des ersten Moduls, wenn der Ansatz mit dem reduzierten Beobachter verwendet wird. Daher wird dieser Ansatz nicht weiter betrachtet. Diese schlechten Testergebnisse sind auf das für den reduzierten Beobachter zu große Rauschen zurückzuführen.
Bei den Testfahrten werden die bei der Reglerauslegung rechnerisch ermittelten Werte nochmals variiert, um zu überprüfen, ob Verbesserungen möglich sind. Dabei ergeben sich noch einige Änderungen für die Auslegung. Bei dem PD-Regler ergibt sich beispielsweise, dass der D-Anteil, im Gegensatz zu den Berechnungen mit dem Modell, wesentlich kleiner sein kann. So werden die besten Ergebnisse mit dem Wert kD = 0,5 erreicht. Obwohl es dabei nach den Berechnungen im Modell zu einem starken Überschwingen kommt. Dies macht den Regler wesentlich schneller. Zum Schwingen kommt es erst, wenn der D-Anteil weiter verkleinert wird. Abb. 12 zeigt die Auswirkung der Veränderung des D-Anteils auf der realen Teststrecke. Der Graph zeigt die kumulierte Häufigkeitsverteilung der Auslenkung des Roboters. Auf der x-Achse sind die Auslenkungen aufgetragen. Der zugeordnete Wert auf der y-Achse gibt an, zu wie viel Prozent der Gesamtstrecke diese Auslenkung überschritten wird. Dies Bedeutet, dass der Regler besser ist, desto höher der Graph verläuft. Wobei zu beachten ist, dass es bei Großen Auslenkungen wesentlich wichtiger ist, dass diese möglichst selten bis gar nicht Überschritten werden. Daher steht ein Graph, der bei niedrigen Abweichungen weiter unten Verläuft, aber sich dann bei Großen Auslenkungen schnell der 100%-Marke annähert besser zu bewerten, als ein Regler, der kleine Abweichungen sehr gut meistert und dann einige Peaks hat, bei denen es zu sehr großen Abweichungen kommt. Mit den neuen Werten ist eine wesentliche Verbesserung zu erkennen. In diesem Fall sind die Abweichungen zwischen der Berechnung und dem realen am Größten. Auch bei den anderen Reglern werden diese Anpassungen vollzogen.


Abb. 12. Kumulierte Häufigkeitsverteilung verschiedener PD-Regler

Ab jetzt sollen nur noch die besten Auslegungen für die verschiedenen Reglerkonzepte verwendet werden. Abb. 13 zeigt die Zeitverläufe der Simulation. Es ist zu erkennen, dass der Mittelwert der Auslenkungen im negativen Bereich liegt. Dies ist auf die Störung in der Kurve zurückzuführen, die nicht stationär genau ausgeregelt wird. Dies ist allerdings auch nicht nötig, da die entstehenden stationären Abweichungen betragsmäßig kleiner als 1◦
sind.

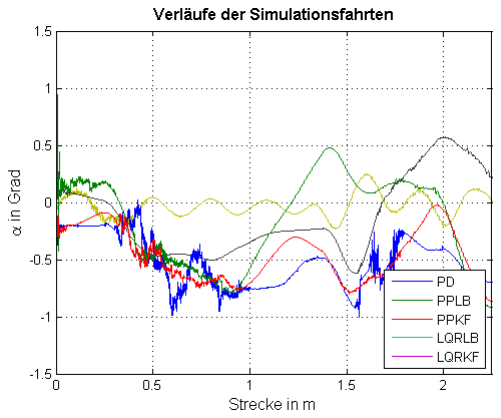
[picture p29: figure]

Abb. 13. Verlauf der Auslenkungen in der Simulation

In der Abb. 14 ist deutlich zu sehen, dass der PD-Regler am besten abschneidet. Auch das PPLB Konzept ist etwas besser zu Bewerten als die anderen Regler.
Bei der realen Teststrecke sind die Abweichungen wesentlich größer. Dies liegt an den wesentlich engeren Kurvenradien. Diese führen zu großen Störgrößen und damit auch zu größeren stationären Abweichungen während der Kurvenfahrt. Anhand des Verlaufs der Auslenkung in Abb. 15 ist gut zu erkennen, wenn der Roboter nach 0,5m in die erste Kurve einfährt. Es kommt zu negativen Auslenkungen. Nach 1,2m fährt er in die zweite Kurve ein und die Abweichungen werden positiv. Nach 1,75m kommt der letzte gerade Abschnitt der Teststrecke. Hier nähern sich die Auslenkungen wieder der

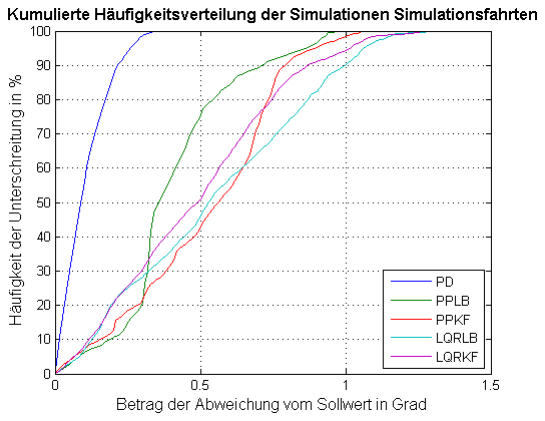
[picture p30: figure]

Abb. 14. Verlauf der Auslenkungen auf der realen Teststrecke

Null an.

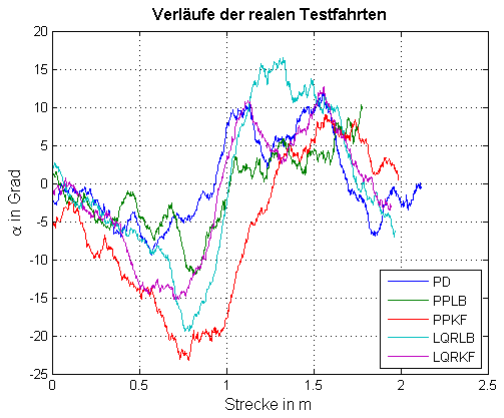
[picture p31: figure]

Abb. 15. Verlauf der realen Testfahrt

Trotz den verschärften Bedingungen schneiden auch hier das Konzept des PD-Reglers sehr gut ab (siehe Abb. 16. Allerdings ist dieser hier nicht klar die beste Methode, wie es bei der Simulation der Fall ist. Das Konzept PPLB schneidet ähnlich gut ab. Auch die anderen Konzepte mit Zustandsreglern sind näher an den PD-Regler herangerückt.

VII. ZUSAMMENFASSUNG UND AUSBLICK

Abschließend lässt sich sagen, dass der Roboter, ohne zu kippen oder stecken zu bleiben, das Rohr auf der realen Teststrecke und in der Simulation durchfahren kann. Damit wird das Ziel der Arbeit erreicht. Bevor die Regler ausgelegt werden konnten, wurde noch ein großer Fokus auf die Entwicklung eines geeigneten Modells des Systems schlangenähnlicher Roboter im Rohr gelegt. Zudem wurde sich mit der Wahl und Bestimmung einer geeigneten Regelgröße sowie deren Messung befasst. So könnte zusätzlich ein linearisiertes Modell erarbeitet werden, was die Reglerauslegung stark unterstützt hat.

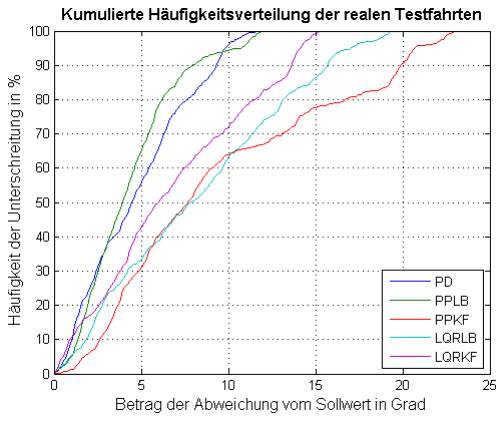
[picture p32: figure]

Abb. 16. Kumulierte Häufigkeitsverteilung der realen Teststrecke

Weitere Verbesserungen können erzielt werden, indem weitere Informationen über das Rohr erfasst werden. So kann z.B. die Störung kompensiert werden, die bei der Kurvenfahrt auftritt, wenn erkannt wird, dass sich der Roboter Momentan in der Kurve befindet. Dabei besteht die Schwierigkeit darin, den exakten Startpunkt der Kurve zu erfassen. Gerade bei der Einfahrt in die Kurve entstehen besonders große Regelabweichungen. Deshalb bringt es keine großen Verbesserungen, wenn die Kurve erst wesentlich später erkannt wird. Weiterhin ist eine Messung des Gierwinkels ψ des Roboters sinnvoll, da so alle Zustandsgrößen bekannt sind und ein Zustandsregler ohne Beobachter entworfen werden kann. Dies ist wünschenswert, da das Modell, das der Beobachter verwendet, um die Zustandsgrößen zu berechnen, abhängig vom Rohrradius ist. Weil sich der Radius im Verlauf des Rohres allerdings ändert, stimmt das Modell nicht in jedem Rohrabschnitt.

LITERATURVERZEICHNIS

[1] M. | Kuther, | „Diese | Roboter | prägen | unsere | Zukunft,”
2018. | [Online]. | Available: | https://www.elektrotechnik.vogel.de/
diese-roboter-praegen-unsere-zukunft-a-733751/ (https://www.elektrotechnik.vogel.de/diese-roboter-praegen-unsere-zukunft-a-733751/)
[2] M. Neumann, T. Predki, L. Heckes, und P. Labenda, „Snake-like, tracked, mobile robot with active flippers for urban search-and-rescue tasks,” Industrial Robot: An International Journal, Vol. 40, 2013.
[3] H. H. Gutbrod, „International Facility for Antiproton and Ion Research (FAIR) at GSI, Darmstadt,” Nuclear Physikcs A, 2005.
[4] Z. Pang, S. Raab, und J. Tamm-morschel, „Validierung eines kinematischen n -Trailer Modells für die Steuerung eines Schlangenroboters,” 2018.
[5] A. Burkert, „Roboter übernehmen die Welt der Produktion,” 2017. [Online]. Available: https://www.springerprofessional.de/industrieroboter/industrie-4-0/roboter-uebernehmen-die-welt-der-produktion/15236792 (https://www.springerprofessional.de/industrieroboter/industrie-4-0/roboter-uebernehmen-die-welt-der-produktion/15236792)
[6] S. Zhangjun und C. Ken, „ROBOTS IN ROUND DUCTS / PIPES,” 2007.
[7] Life.augmented, „iNEMO LSM6DS33 Datasheet,” S. 1–77. [Online]. Available: https://www.st.com/resource/en/datasheet/lsm6ds33.pdf
[8] S. Imer, M. Kempkes, S. R. Klein, und M. Schröder, „Kalibrierung einer Inertial Measurement Unit ( IMU ) für ein UAV,” 2016.
[9] S. Park, „Avionics and control system development for mid-air rendezvous of two unmanned aerial vehicles,” Ph.D. dissertation, Massachusetts Institute of Technology, 2004.
[10] J. Adamy, Systemdynamik und Regelungstechnik II, 5. Aufl. Aachen: Shaker Verlag, 2016.

[11] E. Lenz, „Identifikation dynamischer Systeme : Skript - Wintersemester 2015/16,” 2015. [Online]. Available: https://hds.hebis.de/ulbda/Record/HEB366009699 (https://hds.hebis.de/ulbda/Record/HEB366009699)

Jens Balze hat seinen Bachelor Abschluss in Informatik an der TU Darmstadt gemacht und befindet sich derzeit im Master Studium mit der Vertiefung Autonome Systeme. Diese Fachrichtung hat er gewählt wegen seiner Vorliebe für Robotik und Kraftfahrzeugtechnik. Deshalb war er auch ein Jahr Mitglied beim TU Darmstadt Racing Team e.V. und hat am Formula Student Driverless Fahrzeug mitgearbeitet. Des weiteren ist er als Werksstudent im Bereich der Messtechnik und Datenanalyse tätig.

Nursura Demircan hat ihren Bachelor Abschluss in Mechatronik an der TU Darmstadt gemacht und befindet sich derzeit im Master Studium mit der Vertiefung Allgemeine Mechatronik. Sie hat ein Praktikum in der Türkei in den Bereichen Entwicklung, Produktion und Qualitätssicherung gemacht. Im Weiteren hat sie das Praktikum Regelungstechnik I betreut. Zur Zeit ist sie als Werkstudentin in den Bereichen der Hard- und Softwareentwicklung tätig.

Elias Jargon studiert Mechatronik an der TU Darmstadt. Er hat seine Bachelorarbeit 2018 am Fachgebiet Fahrzeugtechnik im Bereich Fahrsimulation geschrieben. Zurzeit befindet er sich im Masterstudium in der Vertiefungsrichtung der Allgemeinen Mechatronik, in der er die Schwerpunkte auf Regelungstechnik und Robotik legt.

Seyed Davood Mousavi hat seinen Bachelor Abschluss in Electrical Engineering im Fachgebiet Electronic an der Teheran Polytechnic University gemacht. Das Interesse für Mathematik und Robotik brachte ihn an die TU Darmstadt, wo er seinen Master in Automatisierungstechnik macht.
