30sectomars/psas_testbot/doku/pics/Gesamtmodell.JPG

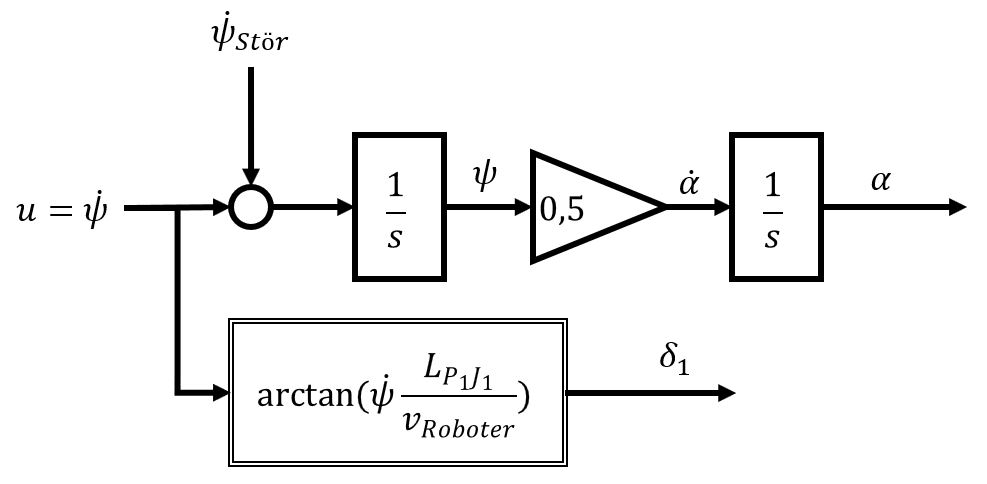
doku/pics/Gesamtmodell.JPG
