30sectomars/psas_testbot/doku/pics/kalman-filter.jpg

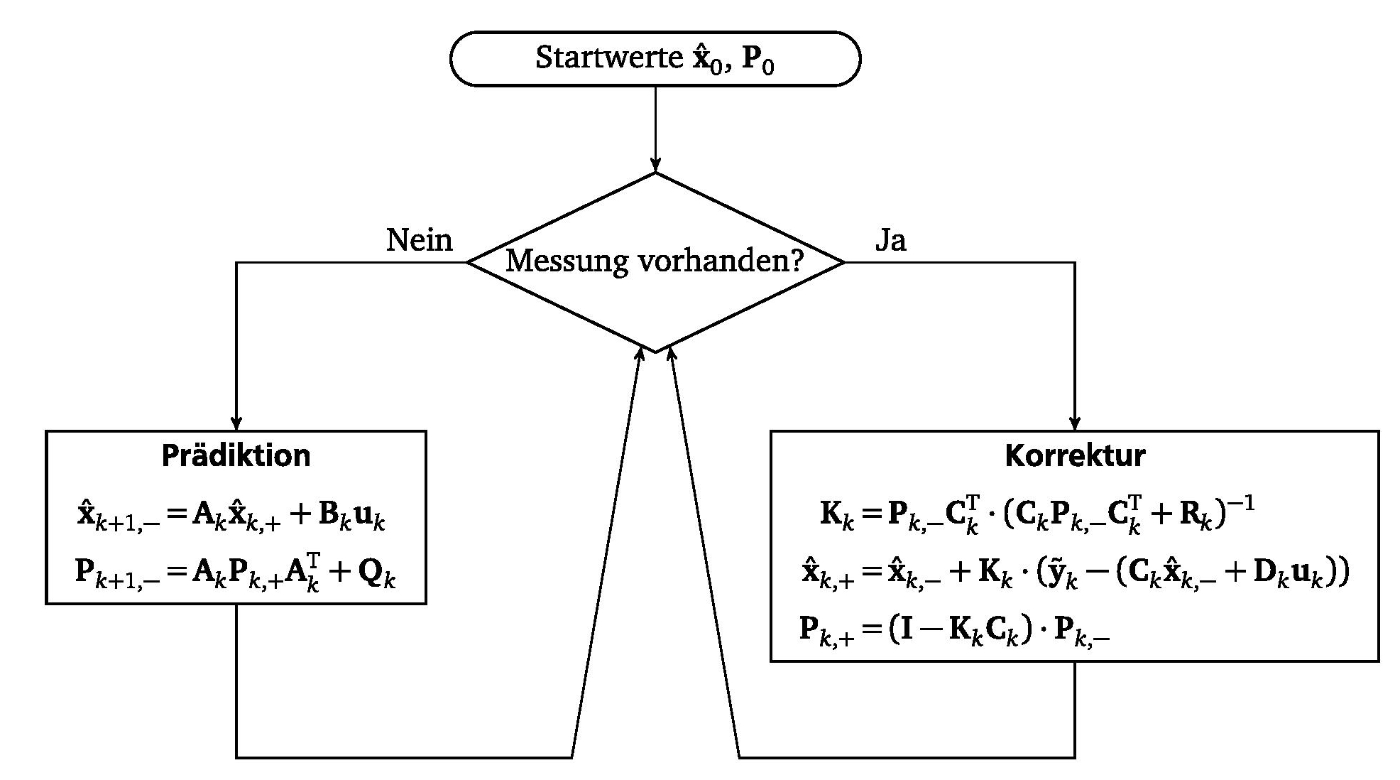
doku/pics/kalman-filter.jpg
