30sectomars/psas_testbot/doku/pics/kalmanreal.png

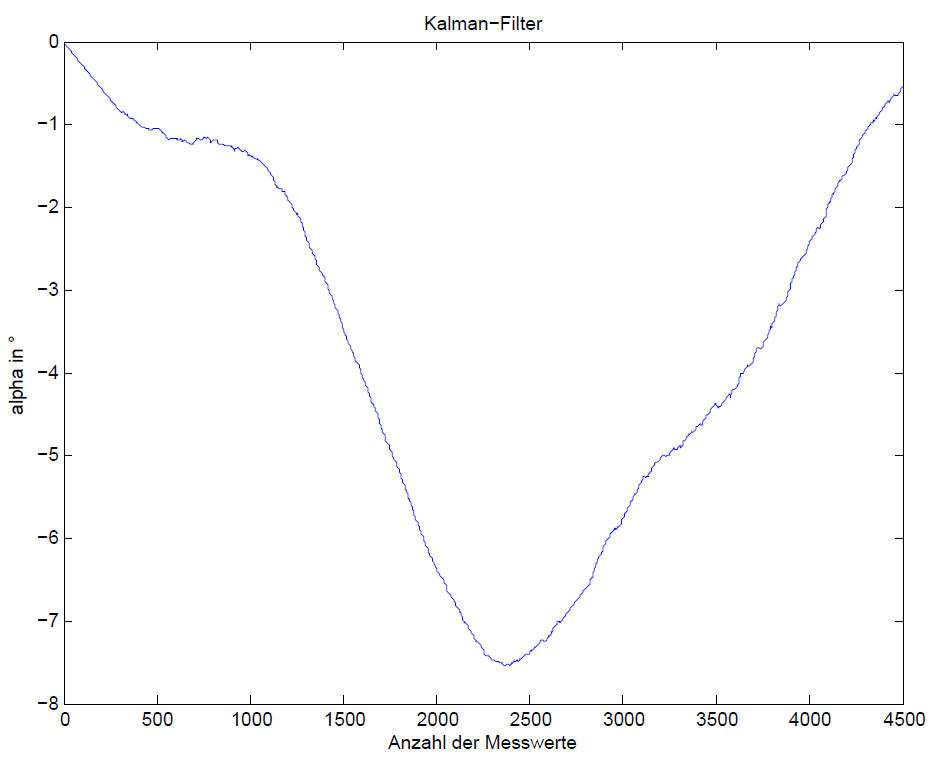
doku/pics/kalmanreal.png
