30sectomars/psas_testbot/doku/pics/Kommunikation.png

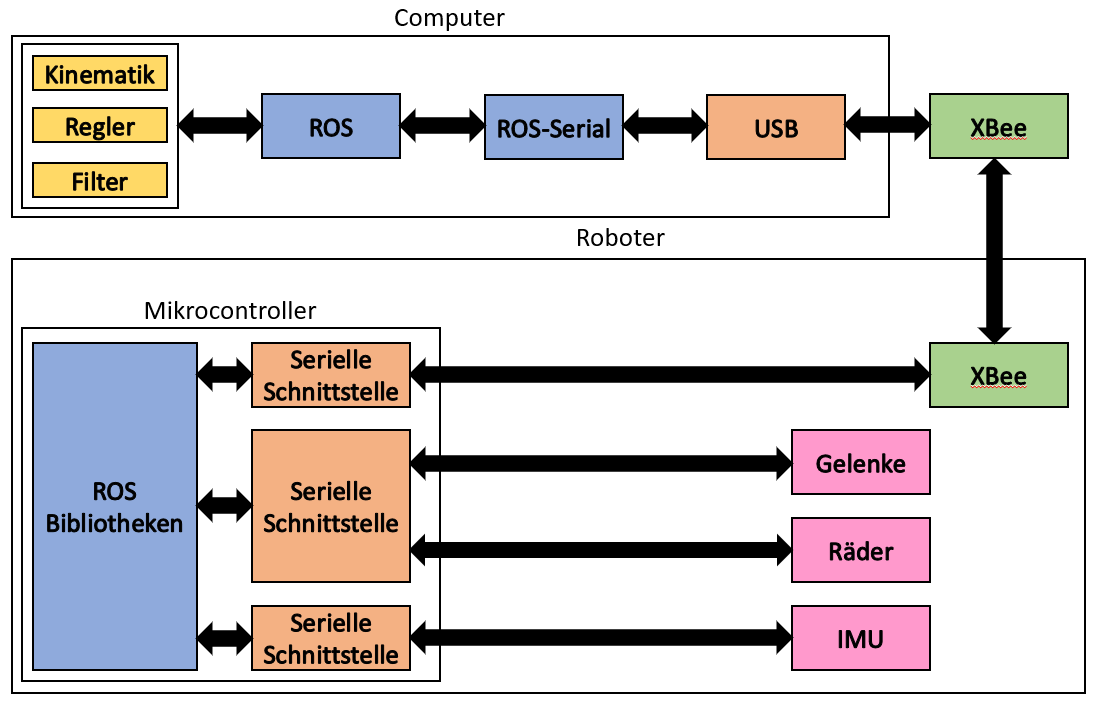
doku/pics/Kommunikation.png
