30sectomars/psas_testbot/doku/pics/kum_haeuf_real.png

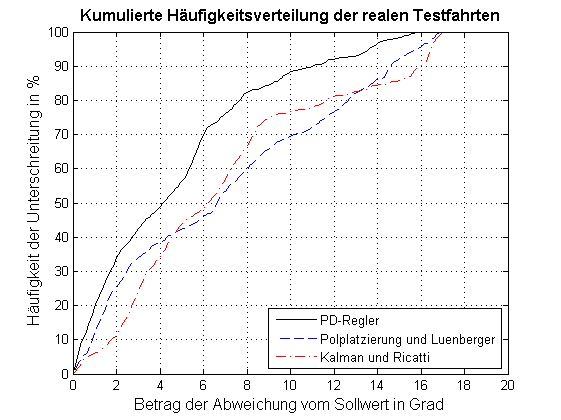
doku/pics/kum_haeuf_real.png
