30sectomars/psas_testbot/doku/pics/Minimalkoordinaten.JPG

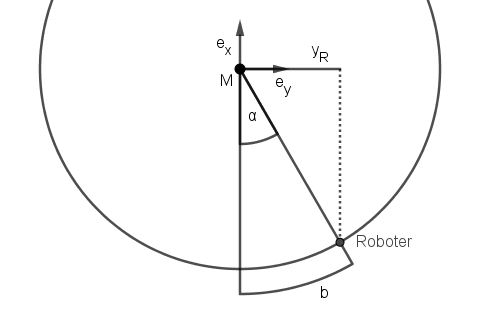
doku/pics/Minimalkoordinaten.JPG
