30sectomars/psas_testbot/doku/pics/pdreal.png

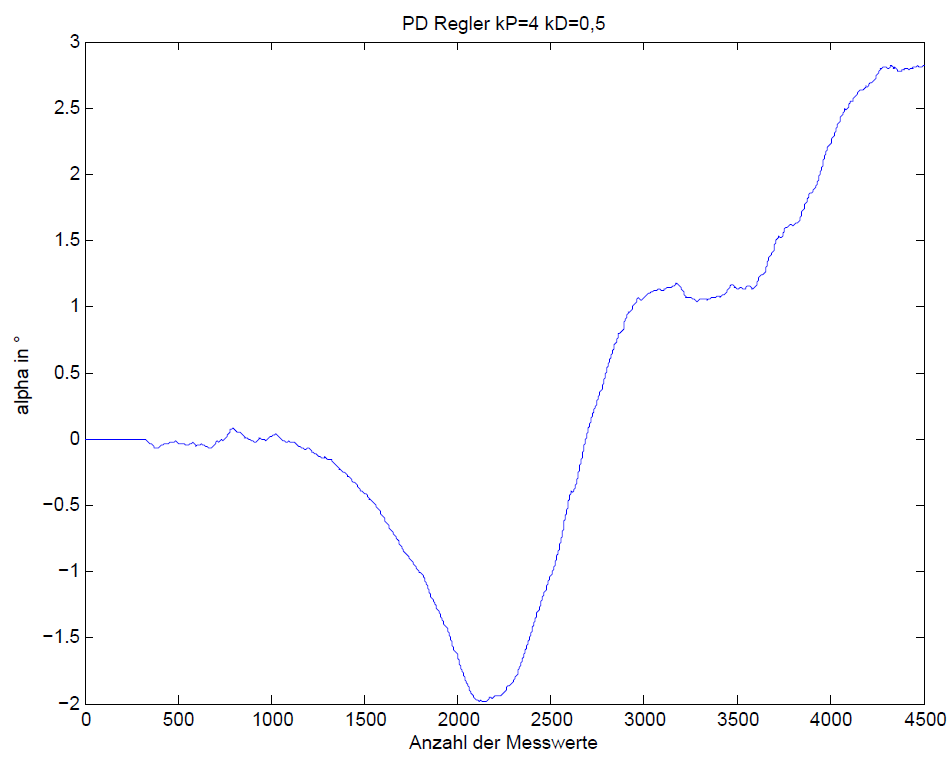
doku/pics/pdreal.png
