30sectomars/psas_testbot/doku/pics/Rohrkoordinaten.JPG

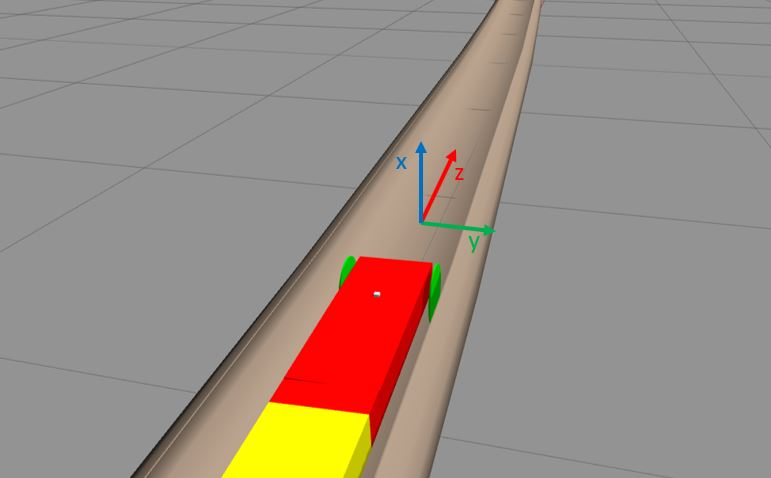
doku/pics/Rohrkoordinaten.JPG
