30sectomars/psas_testbot/doku/pics/Simulation.png

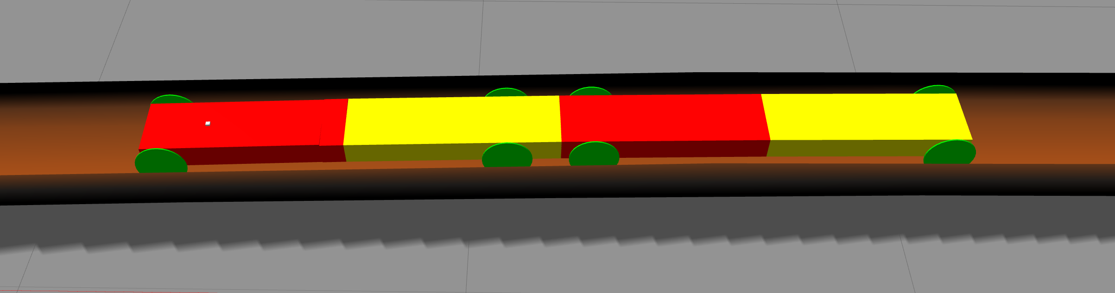
doku/pics/Simulation.png
