30sectomars/psas_testbot/doku/pics/Zeitverlaeufe_real.png

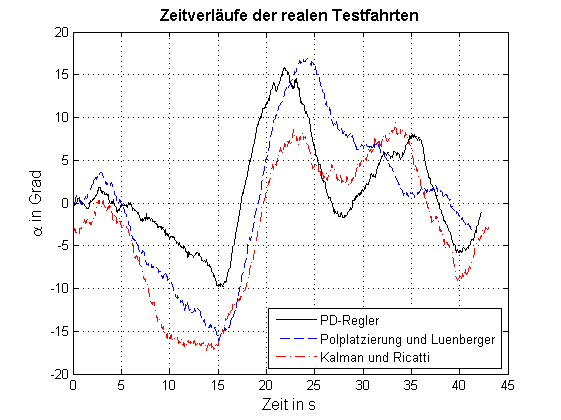
doku/pics/Zeitverlaeufe_real.png
