30sectomars/psas_testbot/doku/pics/zsreal.png

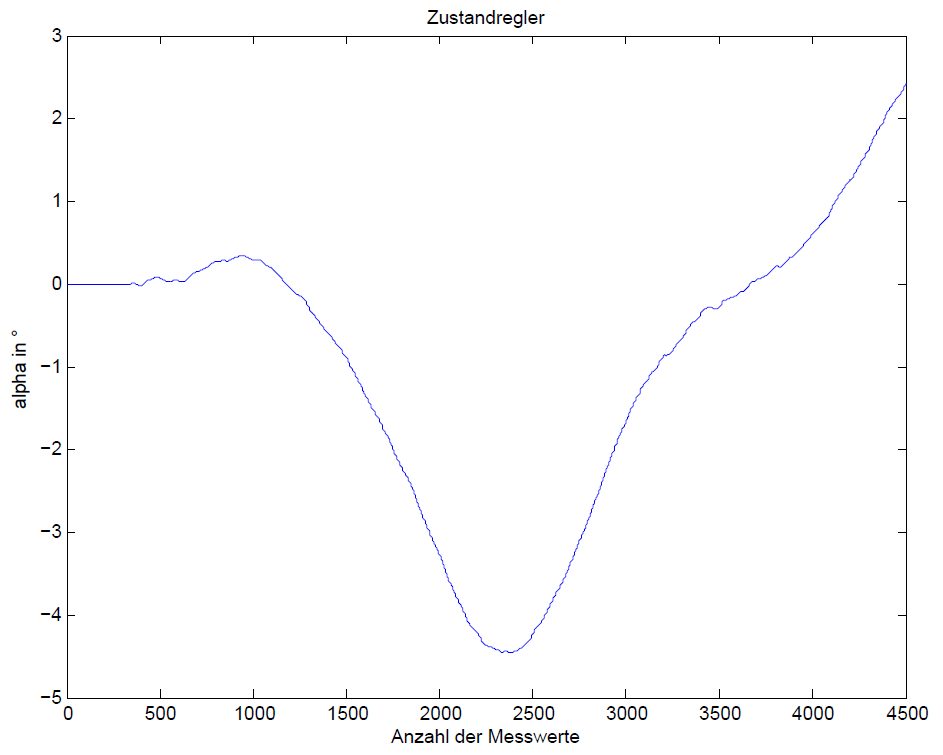
doku/pics/zsreal.png
