30sectomars/psas_testbot/doku/pics/zustandsregler.jpg

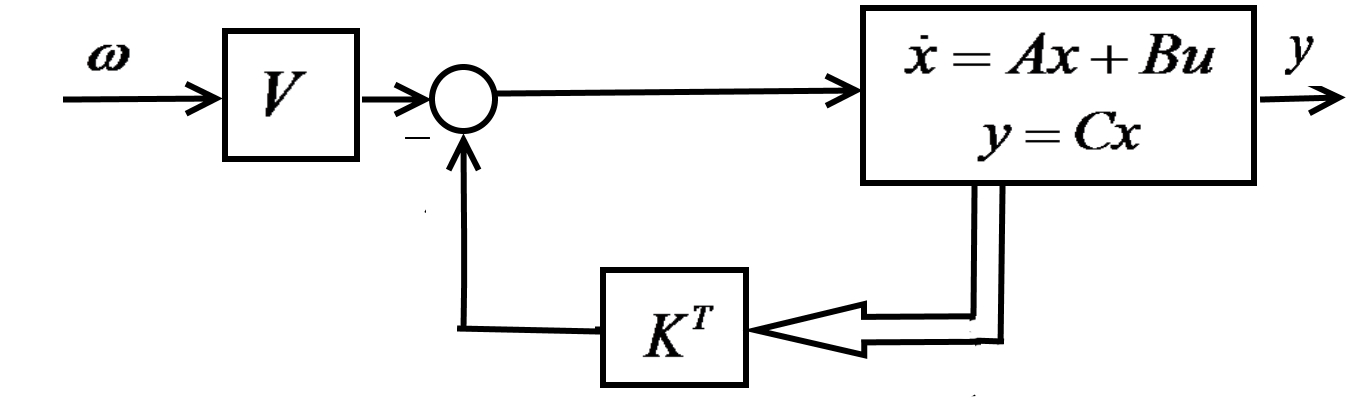
doku/pics/zustandsregler.jpg
