30sectomars/psas_testbot/doku/pics/Teststrecke.jpg

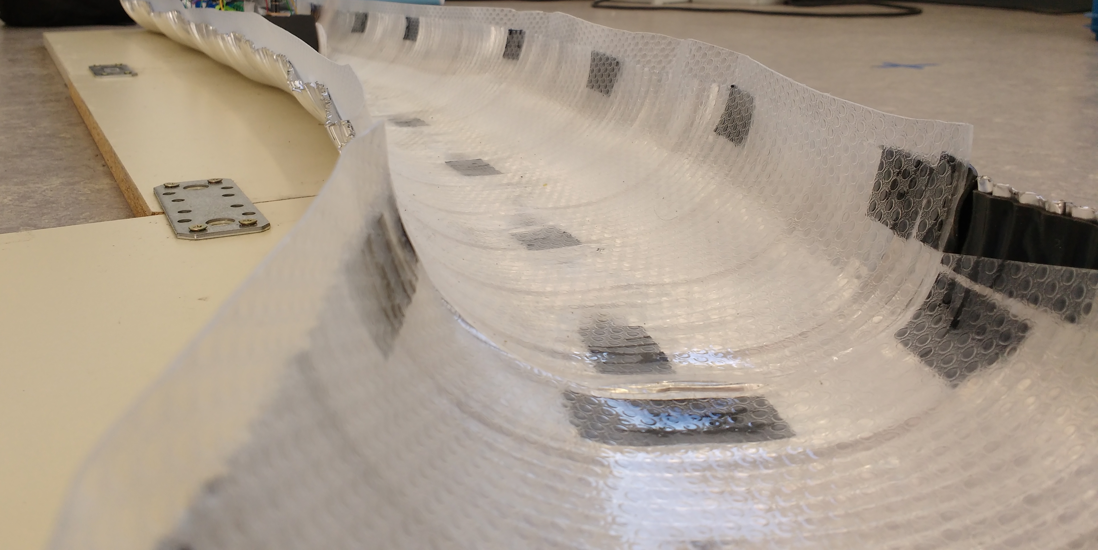
doku/pics/Teststrecke.jpg
