30sectomars/psas_testbot/doku/pics/kalmanreal.pdf

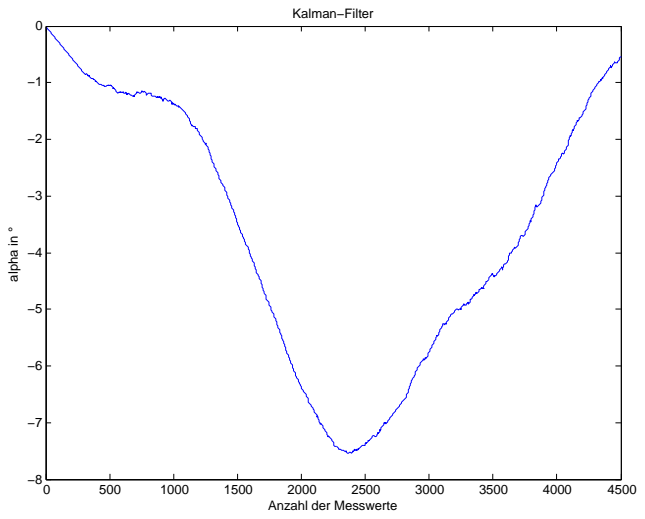
[picture p46: page 1]
Kalman−Filter; alpha in °

Anzahl der Messwerte
