30sectomars/psas_testbot/doku/pics/pdreal.pdf

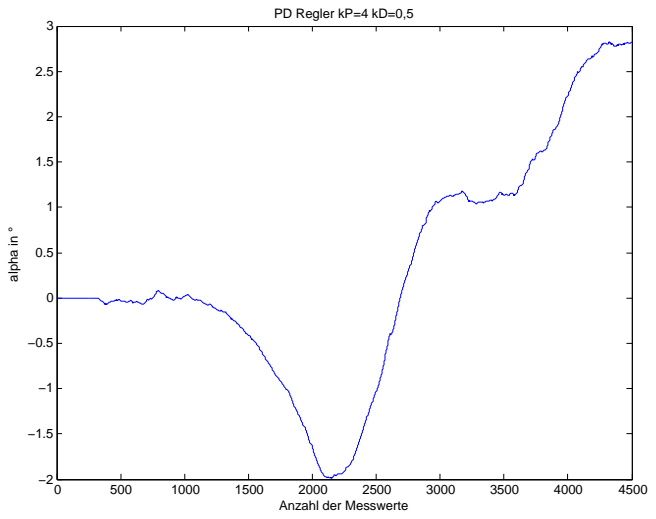
[picture p47: page 1]
alpha in °

PD Regler kP=4 kD=0,5

Anzahl der Messwerte
