30sectomars/psas_testbot/doku/pics/zsreal.pdf

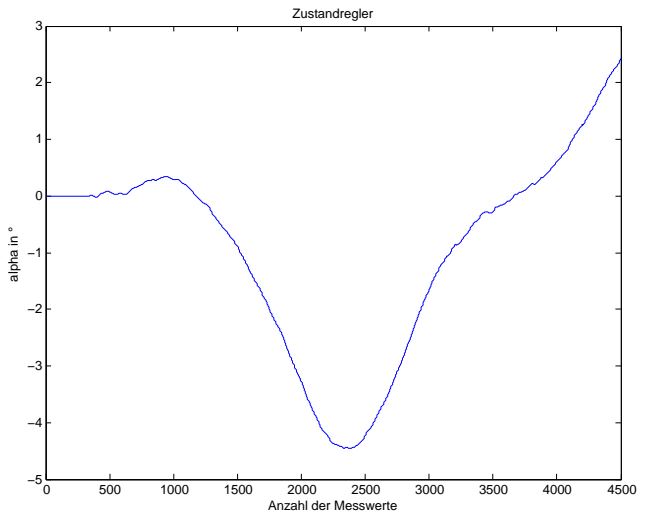
[picture p48: page 1]
Zustandregler; alpha in °

Anzahl der Messwerte
