30sectomars/psas_testbot/(commit log)

2018-12-18 add first verison of pid controller with anti wind up in ros
2018-12-19 pid with anti windup node implementation added
2018-12-19 reverse complementary filter for simulation
2018-12-19 added pid controller to dipole simulation launch file and switch between simulation and real world
2018-12-20 pid controller with anti windup added in simulation and some bugfixes
2018-12-20 add roll_joint to Roboter-Model
    [testbot.xacro]
2018-12-20 IMU auf Modul 0 verschoben
    [testbot.xacro]
2018-12-20 Drehachse von roll_joint verändert
    [testbot.xacro]
2018-12-21 add simulation flag in complementary filter and test some p,i,d values in simulation
2019-01-10 add new controllers and some bugfixes
    [testbot_old.xacro]
2019-01-10 add shutdown function to all controllers and kinematic. Change kinematic looprate to 100hz.
2019-01-15 added parameter for velocity and loop rate. try some controller settings.
2019-01-22 Latex Gliederung für Inbetriebnahme, Teleoperation angepasst auf neue Datenübertragung, Anpassungen Kalman Filter mit Ricatti auf reale Teststrecke
